adafruit/Adafruit-PCF8574-PCB/Adafruit PCF8574 QT.brd

## EAGLE design Adafruit PCF8574 QT.brd (2022-08-02)

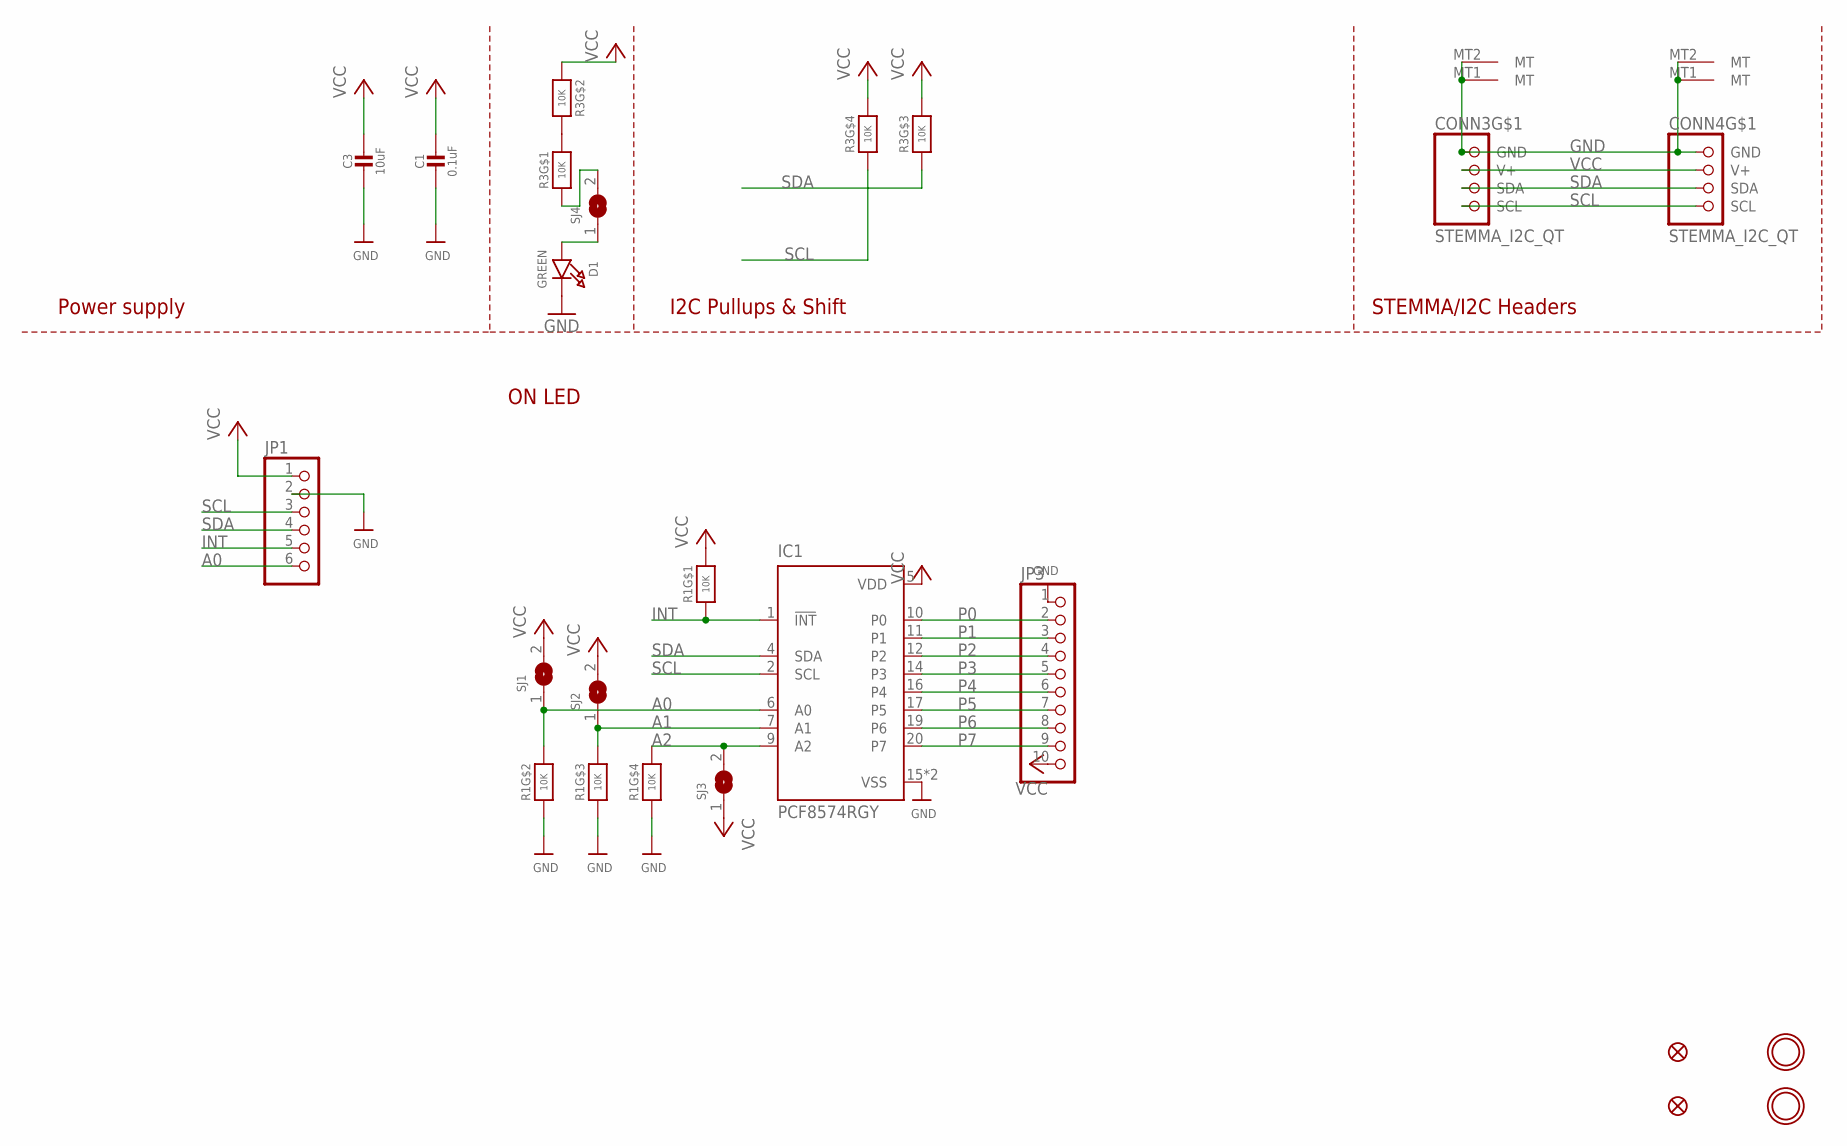
[picture p2: schematic Adafruit PCF8574 QT.sch]

Parts:
C1: 0.1uF; 0603-NO
C3: 10uF; 0805-NO
CONN3, CONN4: STEMMA_I2C_QT; JST_SH4
D1: GREEN; CHIPLED_0603_NOOUTLINE
FID3, FID4: FIDUCIAL_1MM
IC1: PCF8574RGY; VQFN20_3.5X4.5
JP1: HEADER-1X670MIL; 1X06_ROUND_70
JP3: HEADER-1X1070MIL; 1X10_ROUND70
R1, R3: 10K; RESPACK_4X0603
SJ1, SJ2, SJ3: SOLDERJUMPER; SOLDERJUMPER_ARROW_NOPASTE
SJ4: SOLDERJUMPERCLOSED; SOLDERJUMPER_CLOSEDWIRE
U$19, U$21: MOUNTINGHOLE2.5; MOUNTINGHOLE_2.5_PLATED

Connections:
A0: IC1.6 (A0), JP1.6, R1.7 (2), SJ1.1
A1: IC1.7 (A1), R1.6 (2), SJ2.1
A2: IC1.9 (A2), R1.5 (2), SJ3.2
GND: C1.2, C3.2, CONN3.1 (GND), CONN3.MT1 (MT), CONN3.MT2 (MT), CONN4.1 (GND), CONN4.MT1 (MT), CONN4.MT2 (MT), D1.C, IC1.15 (VSS), IC1.21 (VSS), JP1.2, JP3.1, R1.2 (1), R1.3 (1), R1.4 (1)
INT: IC1.1 (!INT), JP1.5, R1.1
unnamed: R3.1, SJ4.2
unnamed: R3.7 (2), R3.8 (2)
unnamed: D1.A, SJ4.1
P0: IC1.10 (P0), JP3.2
P1: IC1.11 (P1), JP3.3
P2: IC1.12 (P2), JP3.4
P3: IC1.14 (P3), JP3.5
P4: IC1.16 (P4), JP3.6
P5: IC1.17 (P5), JP3.7
P6: IC1.19 (P6), JP3.8
P7: IC1.20 (P7), JP3.9
SCL: CONN3.4 (SCL), CONN4.4 (SCL), IC1.2 (SCL), JP1.3, R3.4 (1)
SDA: CONN3.3 (SDA), CONN4.3 (SDA), IC1.4 (SDA), JP1.4, R3.3 (1)
VCC: C1.1, C3.1, CONN3.2 (V+), CONN4.2 (V+), IC1.5 (VDD), JP1.1, JP3.10, R1.8 (2), R3.2 (1), R3.5 (2), R3.6 (2), SJ1.2, SJ2.2, SJ3.1

Notes on the sheet:
I2C Pullups & Shift
STEMMA/I2C Headers
ON LED
Power supply

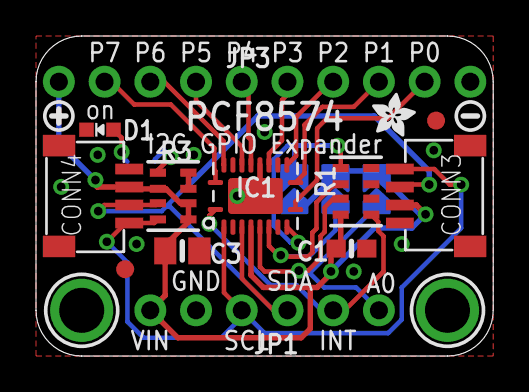
[picture p3: board Adafruit PCF8574 QT.brd from above]

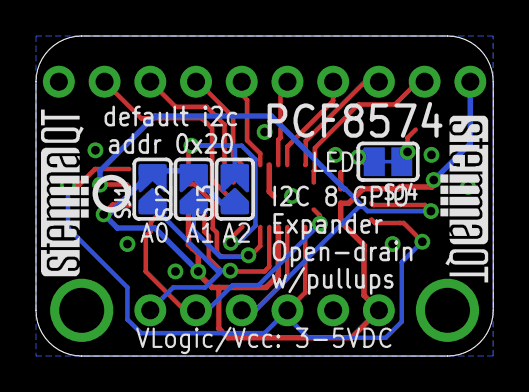
[picture p4: board Adafruit PCF8574 QT.brd from below]

Board: 2 copper layers, 25.4 x 17.8 mm, 24 parts (7 on the bottom side), 19 nets.

Other parts of the board:
U$8: ADAFRUIT_2.5MM
U$9: SYMBOL_MINUS
U$11: SYMBOL_PLUS
U$25: PCBFEAT-REV-040
U$30, U$31: STEMMAQT
